TomasTT7/TT7N-Tracker/Hardware/TT7N v1.2 board.png

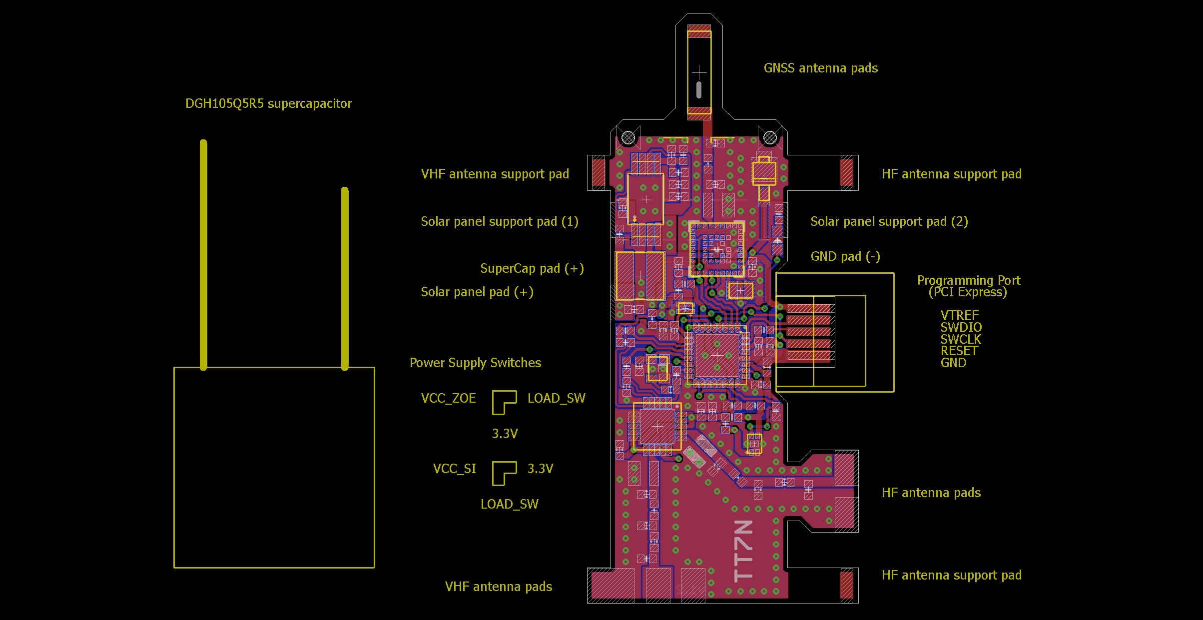
Hardware/TT7N v1.2 board.png
