TomasTT7/TT7N-Tracker/Hardware/TT7N v1.2.brd

## EAGLE design Hardware/TT7N v1.2.brd (2020-03-09)

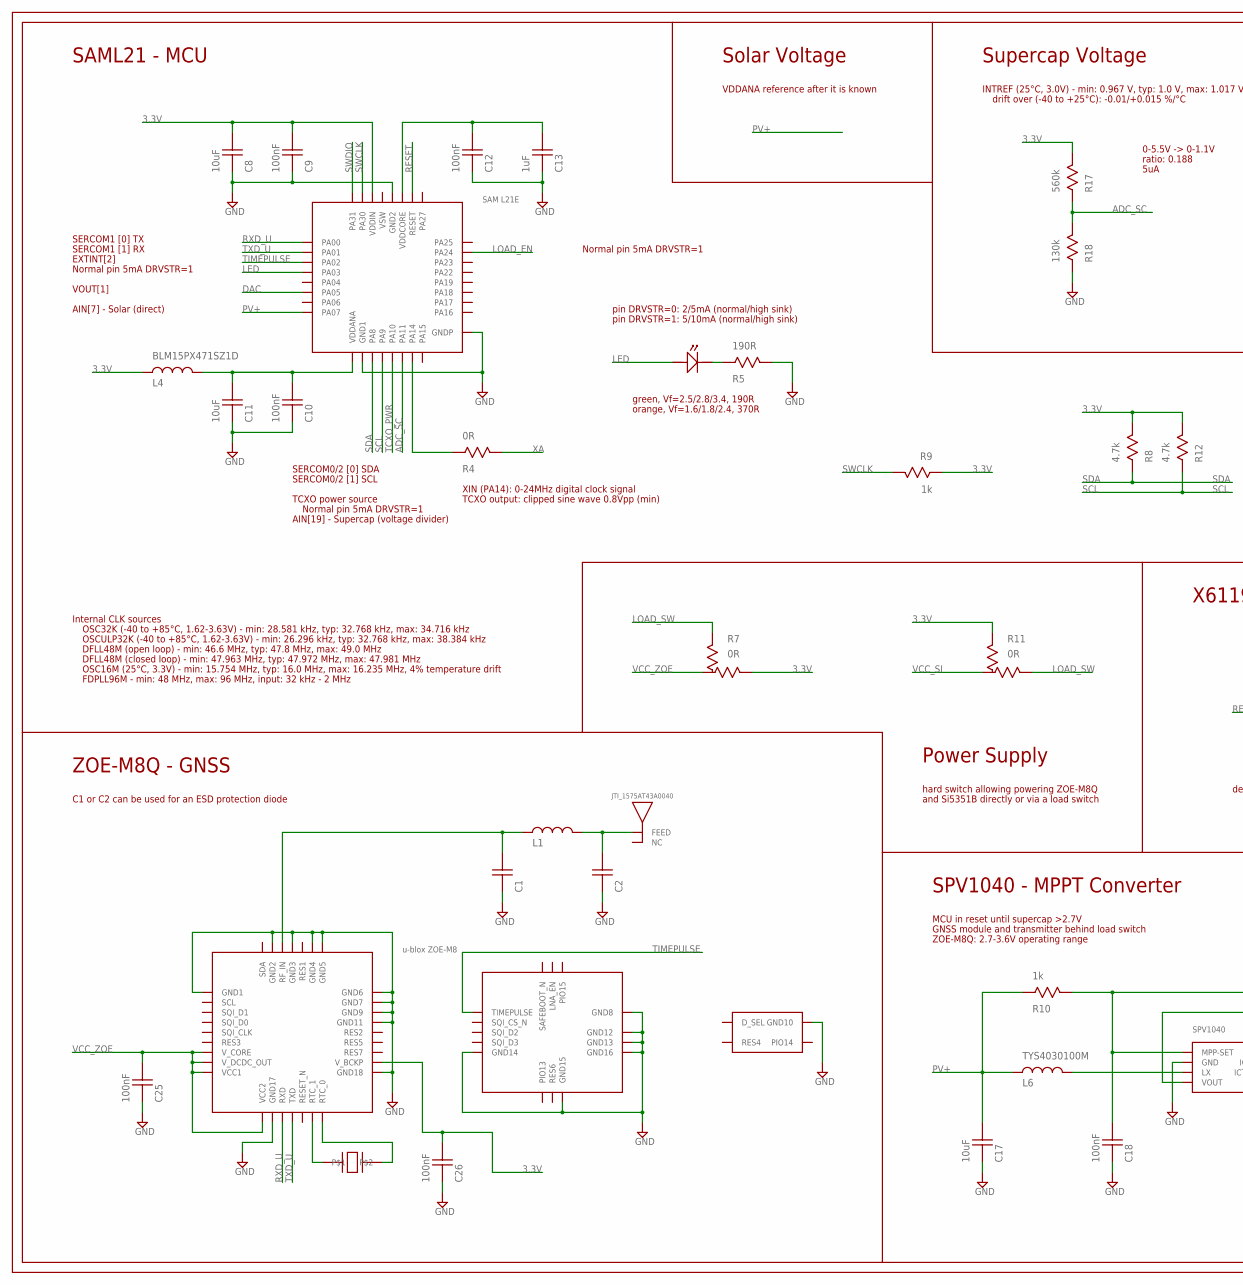
[picture p6: schematic TT7N v1.2.sch, part in row 1, column 1]

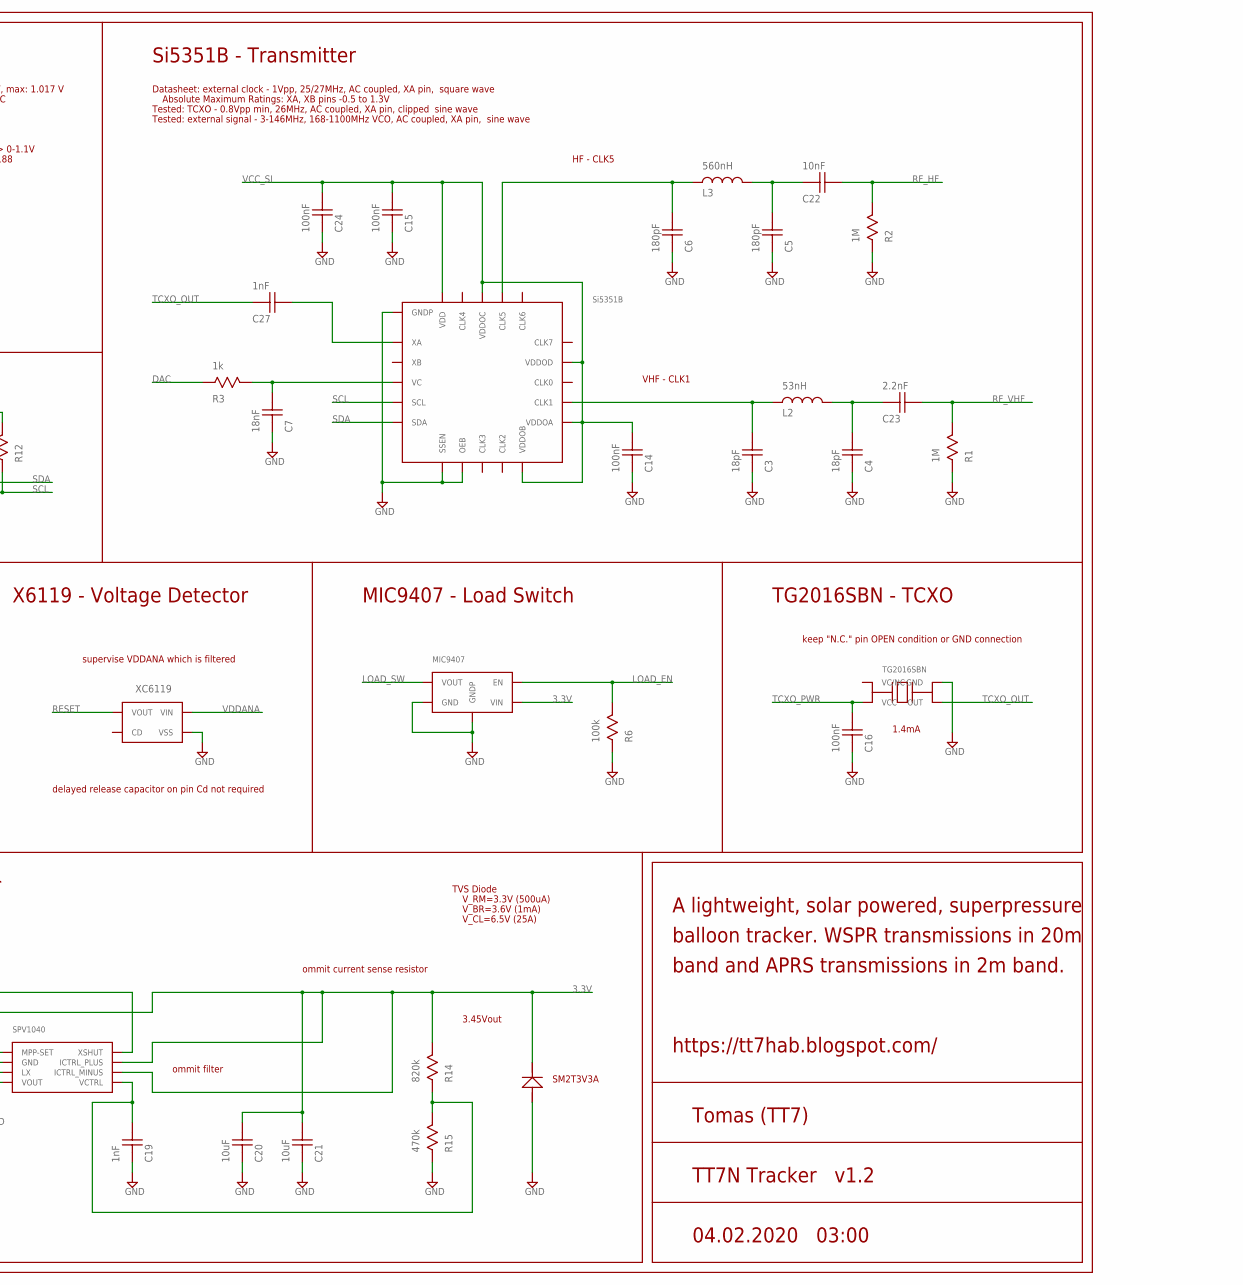
[picture p7: schematic TT7N v1.2.sch, part in row 1, column 2]

Parts:
ANT1: JTI_1575AT43A0040
C1, C2: CAP0402
C3, C4: 18pF; CAP0402
C5, C6: 180pF; CAP0402
C7: 18nF; CAP0402
C8, C11, C17, C20, C21: 10uF; CAP0402
C9, C10, C12, C14, C15, C16, C18, C24, C25, C26: 100nF; CAP0402
C13: 1uF; CAP0402
C19, C27: 1nF; CAP0402
C22: 10nF; CAP0402
C23: 2.2nF; CAP0402
D1: SM2T3V3A
L1: IND0402
L2: 53nH; IND0402
L3: 560nH; IND0402
L4: BLM15PX471SZ1D; IND0402
L6: TYS4030100M
LED1: LED0603
R1, R2: 1M; RES0402
R3, R9, R10: 1k; RES0402
R4: 0R; RES0402
R5: 190R; RES0402
R6: 100k; RES0402
R7, R11: 0R; RES0402-3
R8, R12: 4.7k; RES0402
R14: 820k; RES0402
R15: 470k; RES0402
R17: 560k; RES0402
R18: 130k; RES0402
TCXO1: TG2016SBN
U1: SPV1040
U2: SAML21E18B-MUT
U3: XC6119
U4: UBLOX_ZOE-M8
U5: SI5351B
U6: MIC9407
U7: CM8V-T1A

Connections:
3.3V: C8.P$2, C9.P$2, C20.P$2, C21.P$2, C26.P$2, D1.CATHODE, L4.P$1, R7.3, R8.P$2, R9.P$1, R11.1, R12.P$2, R14.P$2, R17.P$2, U1.ICTRL_MINUS, U1.ICTRL_PLUS, U1.VOUT, U2.VDDIN, U4.V_BCKP, U6.VIN
ADC_SC: R17.P$1, R18.P$2, U2.PA11
CLK1: C3.P$2, L2.P$1, U5.CLK1
CLK5: C6.P$2, L3.P$1, U5.CLK5
DAC: R3.P$1, U2.PA05
GND: C1.P$1, C2.P$1, C3.P$1, C4.P$1, C5.P$1, C6.P$1, C7.P$1, C8.P$1, C9.P$1, C10.P$1, C11.P$1, C12.P$1, C13.P$1, C14.P$1, C15.P$1, C16.P$1, C17.P$1, C18.P$1, C19.P$1, C20.P$1, C21.P$1, C24.P$1, C25.P$1, C26.P$1, D1.ANODE, R1.P$1, R2.P$1, R5.P$2, R6.P$1, R15.P$1, R18.P$1, TCXO1.GND, U1.GND, U2.GND1, U2.GND2, U2.GNDP, U3.VSS, U4.GND1, U4.GND2, U4.GND3, U4.GND4, U4.GND5, U4.GND6, U4.GND7, U4.GND8, U4.GND9, U4.GND10, U4.GND11, U4.GND12, U4.GND13, U4.GND14, U4.GND15, U4.GND16, U4.GND17, U4.GND18, U5.GNDP, U5.OEB, U5.SSEN, U6.GND, U6.GNDP
LED: LED1.ANODE, U2.PA03
LOAD_EN: R6.P$2, U2.PA24, U6.EN
LOAD_SW: R7.1, R11.3, U6.VOUT
unnamed: C7.P$2, R3.P$2, U5.VC
unnamed: R4.P$1, U2.PA14
unnamed: LED1.CATHODE, R5.P$1
unnamed: U4.RTC_0, U7.P$2
unnamed: C12.P$2, C13.P$2, U2.VDDCORE
unnamed: L6.P2, U1.LX
unnamed: C5.P$2, C22.P$1, L3.P$2
unnamed: C18.P$2, R10.P$2, U1.MPP-SET, U1.XSHUT
unnamed: C19.P$2, R14.P$1, R15.P$2, U1.VCTRL
unnamed: U4.RTC_1, U7.P$1
unnamed: C4.P$2, C23.P$1, L2.P$2
PV+: C17.P$2, L6.P1, R10.P$1, U2.PA07
RESET: U2.RESET, U3.VOUT
RF_HF: C22.P$2, R2.P$2
RF_IN: C1.P$2, L1.P$1, U4.RF_IN
RF_UHF: ANT1.FEED, C2.P$2, L1.P$2
RF_VHF: C23.P$2, R1.P$2
RXD_U: U2.PA00, U4.RXD
SCL: R12.P$1, U2.PA09 (PA9), U5.SCL
SDA: R8.P$1, U2.PA08 (PA8), U5.SDA
SWCLK: R9.P$2, U2.PA30
SWDIO: U2.PA31
TCXO_OUT: C27.P$1, TCXO1.OUT
TCXO_PWR: C16.P$2, TCXO1.VCC, U2.PA10
TIMEPULSE: U2.PA02, U4.TIMEPULSE
TXD_U: U2.PA01, U4.TXD
VCC_SI: C14.P$2, C15.P$2, C24.P$2, R11.2, U5.VDD, U5.VDDOA, U5.VDDOB, U5.VDDOC, U5.VDDOD
VCC_ZOE: C25.P$2, R7.2, U4.VCC1, U4.VCC2, U4.V_CORE, U4.V_DCDC_OUT
VDDANA: C10.P$2, C11.P$2, L4.P$2, U2.VDDANA, U3.VIN
XA: C27.P$2, R4.P$2, U5.XA

Notes on the sheet:
pin DRVSTR=0: 2/5mA (normal/high sink)
pin DRVSTR=1: 5/10mA (normal/high sink)
C1 or C2 can be used for an ESD protection diode
green, Vf=2.5/2.8/3.4, 190R
HF - CLK5
VHF - CLK1
MCU in reset until supercap >2.7V
GNSS module and transmitter behind load switch
ZOE-M8Q: 2.7-3.6V operating range
1.4mA
ZOE-M8Q - GNSS
Si5351B - Transmitter
XIN (PA14): 0-24MHz digital clock signal
SPV1040 - MPPT Converter
SAML21 - MCU
ommit filter
3.45Vout
keep "N.C." pin OPEN condition or GND connection
ommit current sense resistor
https://tt7hab.blogspot.com/
TG2016SBN - TCXO
MIC9407 - Load Switch
X6119 - Voltage Detector
supervise VDDANA which is filtered
SERCOM0/2 [0] SDA
SERCOM0/2 [1] SCL
SERCOM1 [0] TX
SERCOM1 [1] RX
VOUT[1]
Normal pin 5mA DRVSTR=1
delayed release capacitor on pin Cd not required
TVS Diode
SM2T3V3A
V_RM=3.3V (500uA)
V_BR=3.6V (1mA)
V_CL=6.5V (25A)
TCXO output: clipped sine wave 0.8Vpp (min)
Solar Voltage
Supercap Voltage
Tomas (TT7)
TT7N Tracker v1.2
04.02.2020 03:00
A lightweight, solar powered, superpressure
0-5.5V -> 0-1.1V
VDDANA reference after it is known
Datasheet: external clock - 1Vpp, 25/27MHz, AC coupled, XA pin, square wave
Tested: TCXO - 0.8Vpp min, 26MHz, AC coupled, XA pin, clipped sine wave
Absolute Maximum Ratings: XA, XB pins -0.5 to 1.3V
Tested: external signal - 3-146MHz, 168-1100MHz VCO, AC coupled, XA pin, sine wave
Internal CLK sources
OSC32K (-40 to +85°C, 1.62-3.63V) - min: 28.581 kHz, typ: 32.768 kHz, max: 34.716 kHz
OSCULP32K (-40 to +85°C, 1.62-3.63V) - min: 26.296 kHz, typ: 32.768 kHz, max: 38.384 kHz
DFLL48M (open loop) - min: 46.6 MHz, typ: 47.8 MHz, max: 49.0 MHz
DFLL48M (closed loop) - min: 47.963 MHz, typ: 47.972 MHz, max: 47.981 MHz
OSC16M (25°C, 3.3V) - min: 15.754 MHz, typ: 16.0 MHz, max: 16.235 MHz, 4% temperature drift
FDPLL96M - min: 48 MHz, max: 96 MHz, input: 32 kHz - 2 MHz
AIN[19] - Supercap (voltage divider)
AIN[7] - Solar (direct)
INTREF (25°C, 3.0V) - min: 0.967 V, typ: 1.0 V, max: 1.017 V
drift over (-40 to +25°C): -0.01/+0.015 %/°C
EXTINT[2]
TCXO power source
orange, Vf=1.6/1.8/2.4, 370R
ratio: 0.188
5uA
Power Supply
hard switch allowing powering ZOE-M8Q
and Si5351B directly or via a load switch
balloon tracker. WSPR transmissions in 20m
band and APRS transmissions in 2m band.

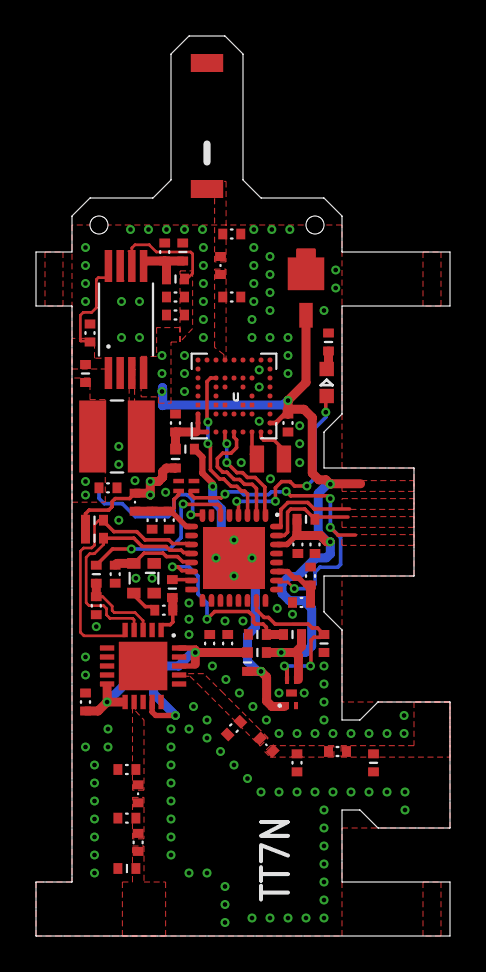
[picture p8: board TT7N v1.2.brd from above]

Board: 2 copper layers, 23.0 x 50.0 mm, 59 parts (0 on the bottom side), 38 nets.
